frdfsnlght/NASOdyssey/README.md

# NASOdyssey
3D printed NAS based on the Odyssey X86J4125864

[Documentaion](https://frdfsnlght.github.io/NASOdyssey/)
