frdfsnlght/NASOdyssey/docs/main-2.jpg

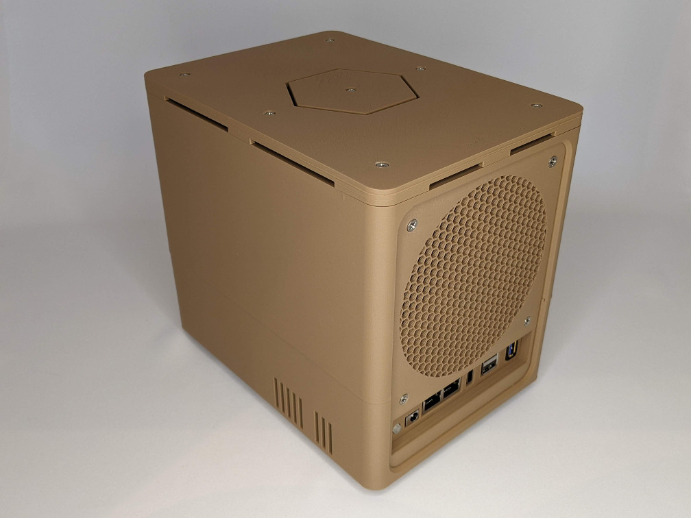
docs/main-2.jpg
