frdfsnlght/NASOdyssey/docs/main-3.jpg

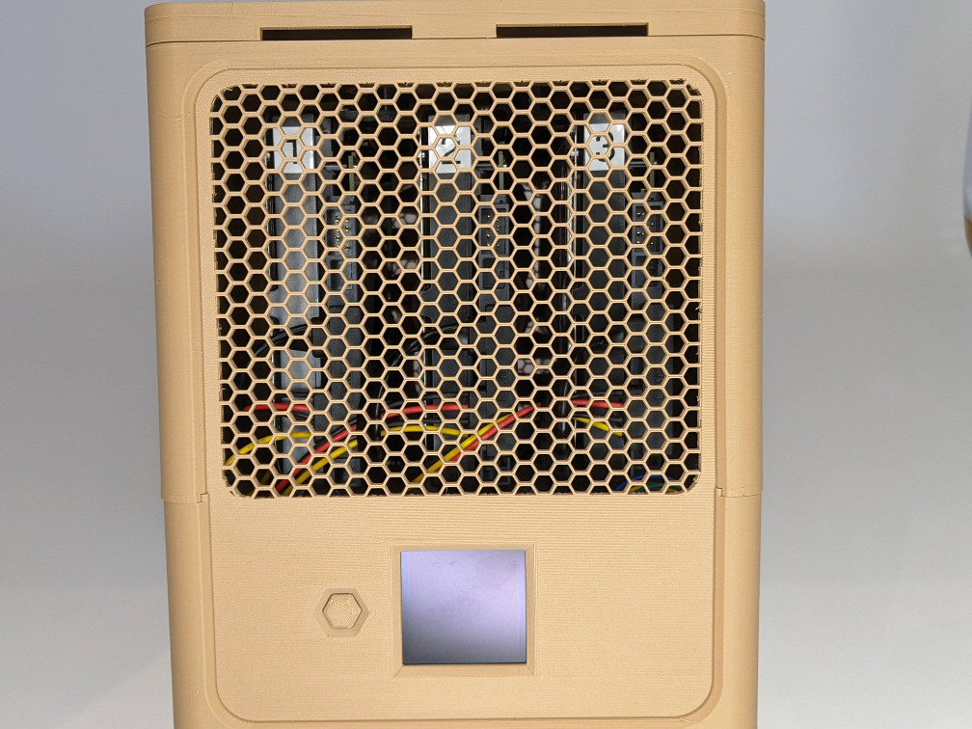
docs/main-3.jpg
