frdfsnlght/NASOdyssey/docs/main-4.jpg

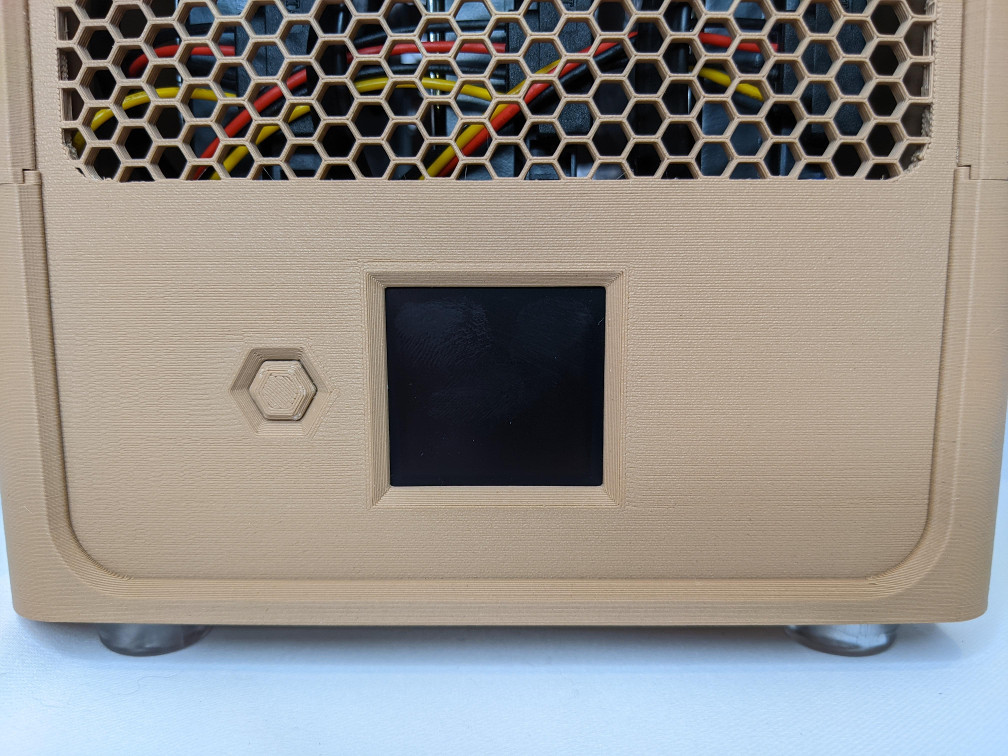
docs/main-4.jpg
