frdfsnlght/NASOdyssey/docs/main-5.jpg

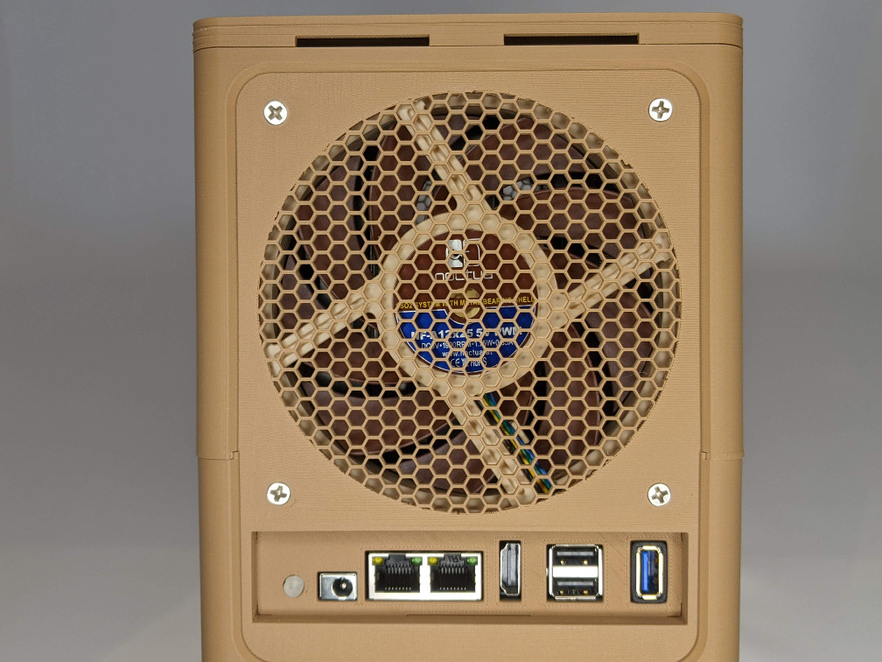
docs/main-5.jpg
