frdfsnlght/NASOdyssey/docs/main-6.jpg

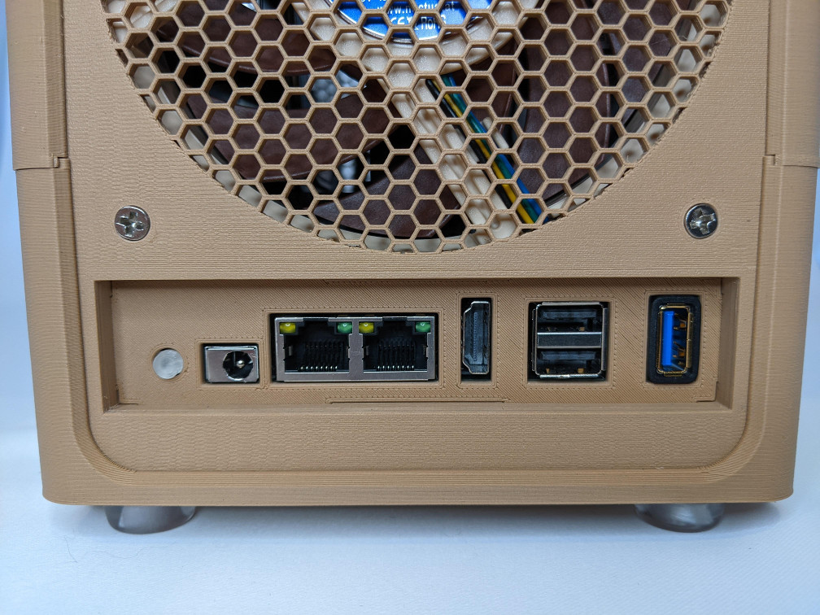
docs/main-6.jpg
