frdfsnlght/NASOdyssey/docs/main-7.jpg

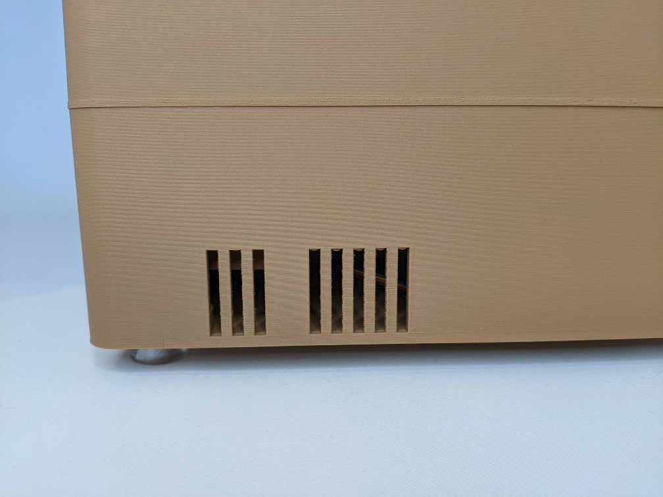
docs/main-7.jpg
