frdfsnlght/NASOdyssey/3D/Case.FCStd

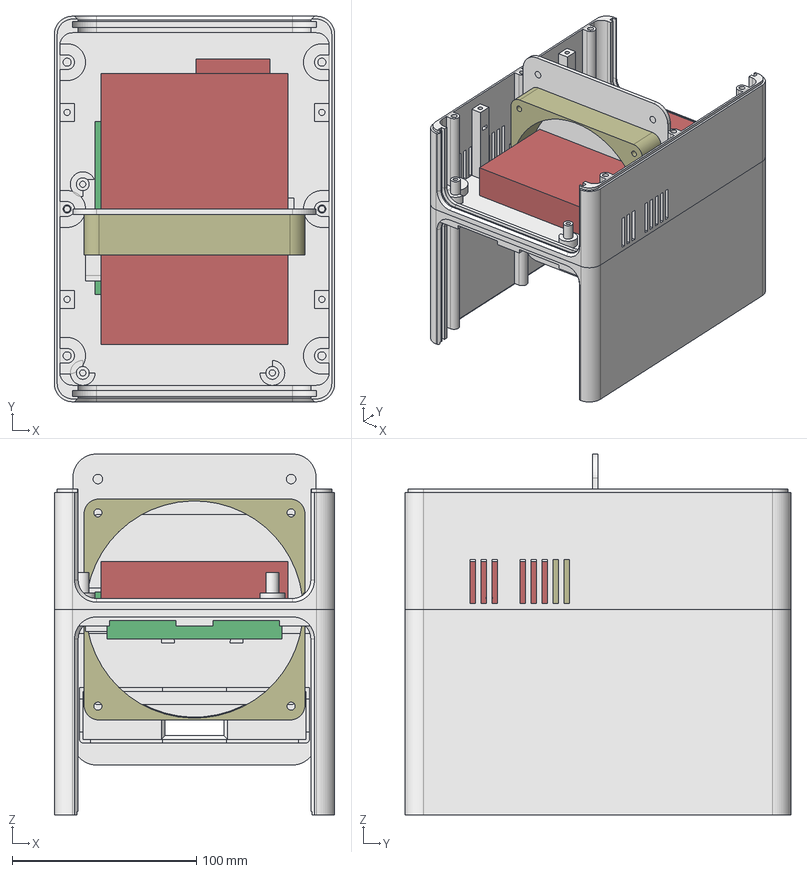
[picture p39: CAD file, 2022-03-27]
3D/Case.FCStd
152.4 x 209.6 x 196.1 mm
OdysseyBody
OLEDBody
ArduinoConnectorBody
ButtonBoardBody
3.5 HDDBody
120mm FanBody
LowerDriveBracketBody
LowerShellBody
UpperShellBody
RearPanelBody
FrontPanelBody
IOPanelBody
OLEDCoverBody
FrontButtonBody
FrontPanelGrillBody
RearPanelGrillBody
USB3 Socket Body
UpperDriveBracketBody
CapShellBody
CapCutoutBody
LowerShellGrillBody
PowerButtonBody
