frdfsnlght/NASOdyssey/3D/STLs/Case-LowerShellGrill.stl

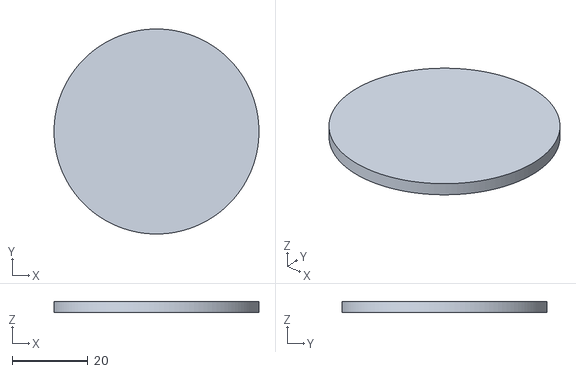
[picture p40: CAD file, 2022-03-24]
3D/STLs/Case-LowerShellGrill.stl
54.0 x 54.0 x 3.00
