frdfsnlght/NASOdyssey/3D/STLs/Case-FrontPanelGrill.stl

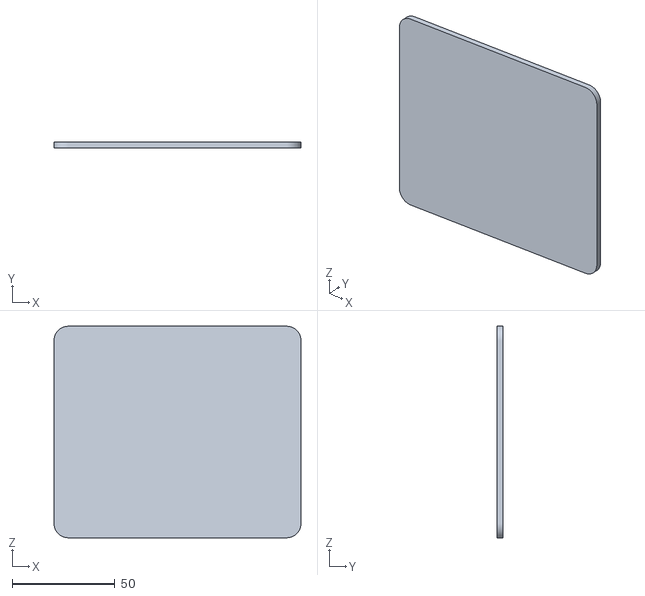
[picture p41: CAD file, 2022-03-24]
3D/STLs/Case-FrontPanelGrill.stl
120.2 x 3.00 x 103.0
