frdfsnlght/NASOdyssey/3D/STLs/Case-FrontButton.stl

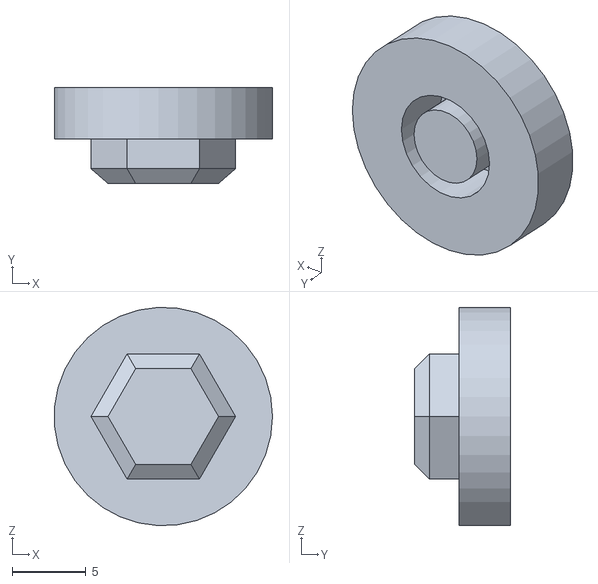
[picture p42: CAD file, 2022-03-24]
3D/STLs/Case-FrontButton.stl
14.8 x 6.50 x 14.8
