frdfsnlght/NASOdyssey/3D/STLs/Case-PowerButton.stl

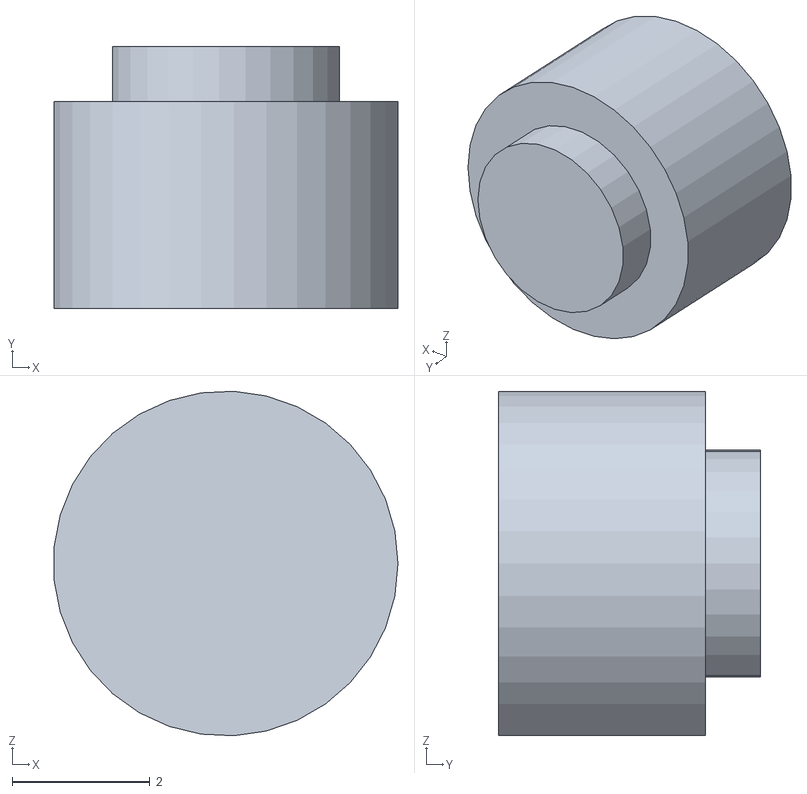
[picture p43: CAD file, 2022-03-24]
3D/STLs/Case-PowerButton.stl
4.99 x 3.80 x 4.99
