frdfsnlght/NASOdyssey/3D/STLs/Case-RearPanelGrill.stl

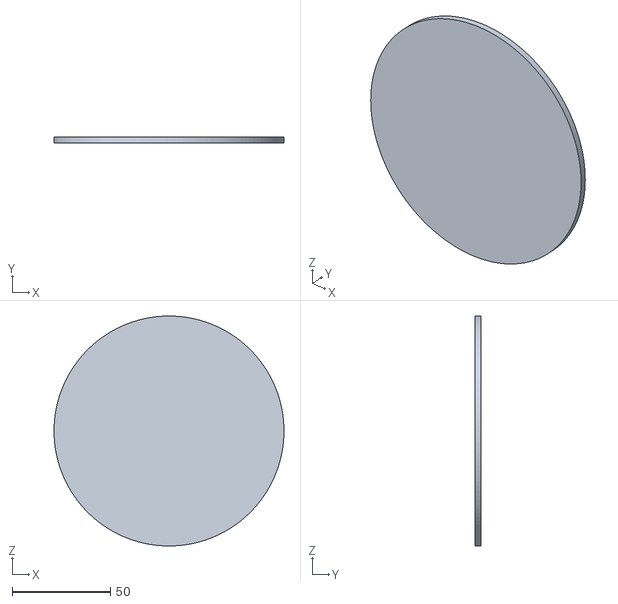
[picture p44: CAD file, 2022-03-24]
3D/STLs/Case-RearPanelGrill.stl
117.0 x 3.00 x 117.0
