frdfsnlght/NASOdyssey/PCB/ArduinoConnector/ArduinoConnector.kicad_pcb

## KiCad design PCB/ArduinoConnector/ArduinoConnector.kicad_pcb (2022-03-17)

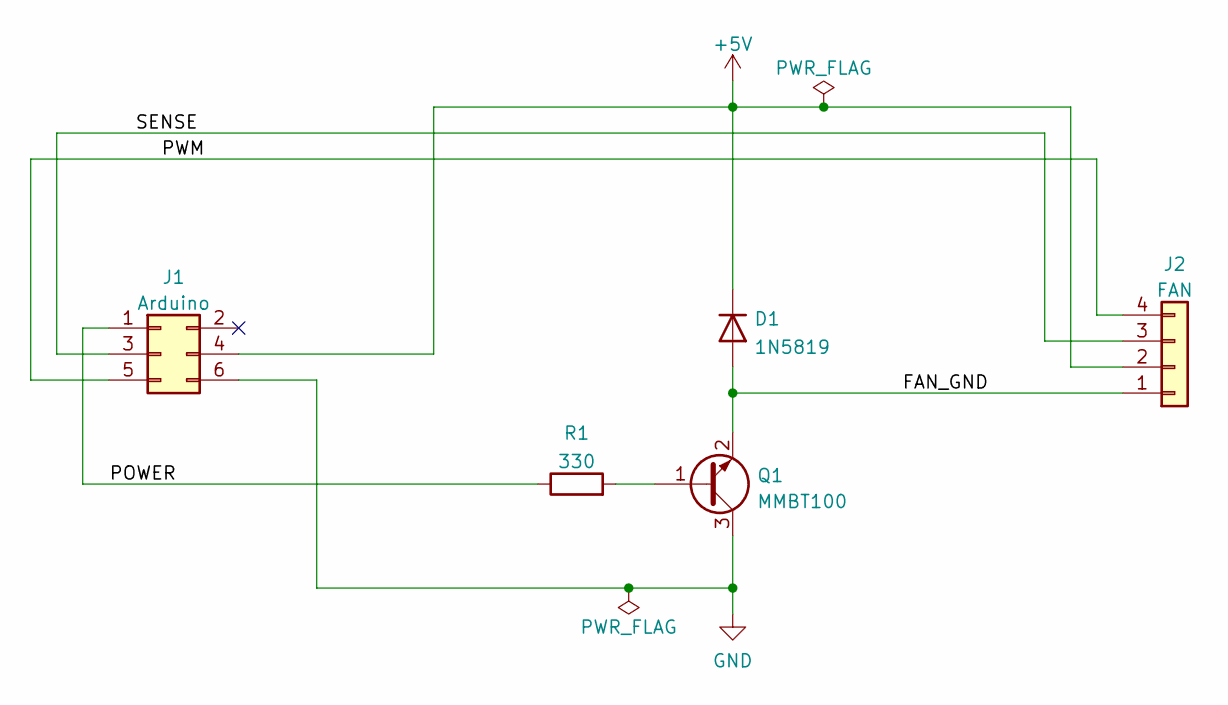
[picture p45: schematic ArduinoConnector.kicad_sch]

Parts:
D1: 1N5819; D_SMA
J1: Arduino; PinHeader_2x03_P2.54mm_Vertical
J2: FAN; Molex_KK-254_AE-6410-04A_1x04_P2.54mm_Vertical
Q1: MMBT100; SOT-23
R1: 330; R_0805_2012Metric

Connections:
+5V: D1.1 (K), J1.4, J2.2
/FAN_GND: D1.2 (A), J2.1, Q1.2 (E)
/POWER: J1.1, R1.1
/PWM: J1.5, J2.4
/SENSE: J1.3, J2.3
GND: J1.6, Q1.3 (C)
unnamed: Q1.1 (B), R1.2

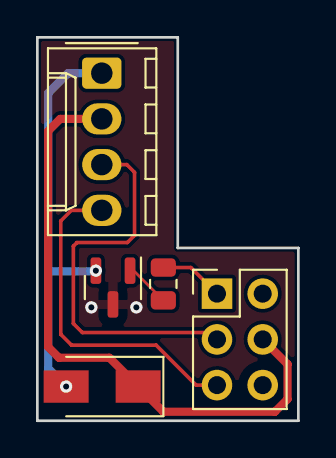
[picture p46: board ArduinoConnector.kicad_pcb from above]

Board: 2 copper layers, 14.5 x 21.3 mm, 5 parts (0 on the bottom side), 7 nets.
