frdfsnlght/NASOdyssey/PCB/ButtonBoard/ButtonBoard.kicad_pcb

## KiCad design PCB/ButtonBoard/ButtonBoard.kicad_pcb (2022-03-13)

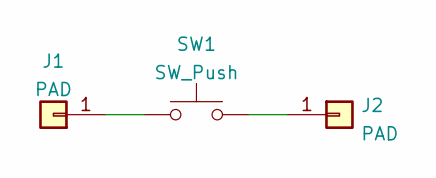
[picture p47: schematic ButtonBoard.kicad_sch]

Parts:
J1, J2: PAD; Pin_D1.3mm_L11.0mm
SW1: SW_Push; SW_Push_1P1T_NO_6x6mm_H9.5mm

Connections:
unnamed: J1.1, SW1.1
unnamed: J2.1, SW1.2

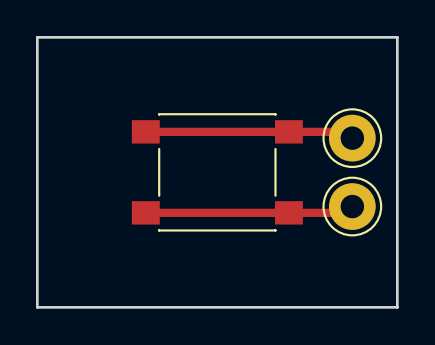
[picture p48: board ButtonBoard.kicad_pcb from above]

Board: 2 copper layers, 20.0 x 15.0 mm, 3 parts (0 on the bottom side), 2 nets.
