frdfsnlght/NASOdyssey/(commit log)

2022-03-11 Initial PCB circuit
    [ArduinoConnector.kicad_pcb, ArduinoConnector.kicad_sch]
2022-03-12 New PCBs
    [ArduinoConnector.kicad_pcb, ArduinoConnector.kicad_sch, ButtonBoard.kicad_pcb, ButtonBoard.kicad_sch]
2022-03-13 Generated gerbers
    [ArduinoConnector-B_Cu.gbl, ArduinoConnector-B_Mask.gbs, ArduinoConnector-B_Silkscreen.gbo, ArduinoConnector-Edge_Cuts.gm1, ArduinoConnector-F_Cu.gtl, ArduinoConnector-F_Mask.gts, ArduinoConnector-F_Silkscreen.gto, ArduinoConnector-job.gbrjob]
2022-03-13 Switched tx/rx position
2022-03-14 Beginning case design
    [Case.FCStd]
2022-03-15 More work done
    [Case.FCStd]
2022-03-16 More work
    [Case.FCStd]
2022-03-16 Changed pin assignments and redid the PCB
    [ArduinoConnector.kicad_pcb, ArduinoConnector.kicad_sch]
2022-03-17 Trying to fix fan RPM sensing
    [ArduinoFan.ino]
2022-03-17 Fucking around with the PCB layout
    [ArduinoConnector.kicad_pcb]
2022-03-17 Updated ArduinoFan README
2022-03-17 New version of the ArduinoConnector
    [ArduinoConnector-B_Cu.gbl, ArduinoConnector-B_Mask.gbs, ArduinoConnector-B_Silkscreen.gbo, ArduinoConnector-Edge_Cuts.gm1, ArduinoConnector-F_Cu.gtl, ArduinoConnector-F_Mask.gts, ArduinoConnector-F_Silkscreen.gto, ArduinoConnector-job.gbrjob]
2022-03-22 Tweaked printing info
2022-03-22 Final designs pending any tweaks
    [Case.FCStd]
2022-03-24 Design finalized
    [Case-CapCutout.stl, Case-CapShell.stl, Case-FrontButton.stl, Case-FrontPanel.stl, Case-FrontPanelGrill.stl, Case-IOPanel.stl, Case-LowerDriveBracket.stl, Case-LowerShell.stl]
2022-03-29 Prevent screen from clearing on shutdown
    [sysmon.py]
2022-04-07 Changed fan curve, FS path
